ht1580/Quietmirror-mouse/references/V0.9_REFERENCE_NOTES.md

# V0.9 reference review and acceptance notes

Reviewed: 2026-10-15. This review is read-only with respect to the model; it does not certify the generated V0.9 CAD or print results.

## Meaning of the requested references

The existing repository explicitly identifies `minise` as **Razer Viper Mini Signature Edition**, in `references/FINALMOUSE_MINISE_REFERENCE.md`. `references/V0.7_REFERENCE_NOTES.md` identifies `v3p` as **Razer Viper V3 Pro**. This is stronger evidence than the initial alternative interpretation of WLmouse Mini SE. `v4p` is interpreted as **Razer Viper V4 Pro**, supported by the current official product and support pages; the abbreviation remains an inference rather than a new statement from the user.

Official primary sources read during this review:

- Viper V3 Pro: https://www.razer.com/gaming-mice/razer-viper-v3-pro
- Viper V4 Pro: https://www.razer.com/gaming-mice/razer-viper-v4-pro
- Viper V4 Pro support: https://mysupport.razer.com/app/answers/detail/a_id/20775/
- Viper Mini Signature Edition: https://www.razer.com/gb-en/gaming-mice/razer-viper-mini-signature-edition
- Mini SE manufacturing description: https://www.razer.com/newsroom/product-news/razer-unveils-the-viper-mini-signature-edition-a-magnesium-alloy-gaming-masterpiece

Official images actually downloaded and visually inspected (local private design reference, not assets to republish as the project artwork):

| Local file under `_support/work/reference_review_v09/` | Official URL | Useful observation |
|---|---|---|
| `viper_v3pro_angle2.webp` | https://assets2.razerzone.com/images/pnx.assets/474a68bae599387eb85e884c484e9ce3/angle_2.webp | Main buttons remain broad complete touch surfaces. Their outside margins continue the sidewall silhouette with a small moving seam, rather than sitting inside broad projecting shoulders. |
| `viper_v4pro_geometry.webp` | https://assets2.razerzone.com/images/pnx.assets/eb5fbd749917af6235780a1bdba7bdac/tadpoles-mobile.webp | The front button outside edge and middle body read as a coherent side contour. The product has independent moving buttons; aesthetic continuity must not eliminate their clearance. |
| `viper_mini_se.webp` | https://assets2.razerzone.com/images/pnx.assets/cd30df436fb4bd17b1da6165a8941d6f/razer-viper-mini-se-1300x600-top-1.webp | Solid front buttons and side contact areas transition to an open rear lattice with large triangular and polygonal windows, rounded vertices, and deliberate ribs. The photograph itself does not establish that every Mini SE opening is a triangle. |

The manufacturer's magnesium construction does not establish printable PLA wall thickness or rib strength. No commercial CAD, exact dimensions, internal mechanism, electronics or branding is copied. User direction for all decorative cutouts to be triangles takes precedence over the mixed polygons visible in the style reference.

## Reading the two supplied annotations

Both clipboard PNGs were actually inspected. In image 1 the main buttons are at the **front** (top of the pictured plan view); the user is correcting orientation, not asking to move the buttons to a different physical side. The two red loops mark the bulging lateral shoulders alongside the main buttons, not the button touch surfaces themselves. Remove or draw in these shoulders while keeping each key's 23 x 27 mm design footprint.

In image 2, front is left and rear is right. The red line specifies a continuous descending back profile from the crown to the tail. A low-poly display with smooth shading is not evidence that the underlying CAD profile is smooth. Check the outer envelope independently from hole boundaries and decorative ribs.

## Agreed implementation envelope from the main agent

The initial interpretation retained the nominal 90 x 62 mm plan size and 23 x 27 mm button touch sizes. The user's later marked revision explicitly permits rear narrowing while preserving the front contour/pitch and contact faces; actual final dimensions must come from the current reports. Height reduces from about 28 to about 26 mm, ordinary wall target from about 1.8 to about 1.6 mm, and planar lattice-rib target from about 2.2 to about 1.8 mm, subject to valid CAD and PLA slicing. These are project design choices, not dimensions inferred from the reference photographs. Only the thin upper main keys move; the lower skirt, closed front and USB support remain fixed.

Reduction of wall thickness, rib width, and envelope height are three different operations. Report their achieved values independently. Preserve the source V0.8 assets for comparison and rollback.

## Independent acceptance checklist

### Visible user intent

- Compare orthographic top and left-side renders of V0.8 and V0.9 at the same scale, using the button end as the front. Include an unobstructed front view.
- In plan view, the formerly marked outside shoulders must be visibly removed or drawn in; the transition must remain smooth without shrinking the button touch footprint.
- In side view, trace the crown-to-tail envelope and inspect its slope across each loft join. Look for kinks, steps and local humps, rather than relying on smoothing in the renderer.
- All intentional decorative/weight-saving shell windows must have three principal sides, with modest corner rounding permitted for PLA. A list of cutter definitions alone is insufficient if cuts merge into a non-triangular final window.
- Keep functional apertures (sensor, switch access, wheel gap, screw holes and axles) identifiable separately. Do not claim that every aperture is triangular if these functional interfaces retain their necessary shapes.
- Retain broad complete finger contact surfaces and usable side grasp bands. Thinner ribs must still form connected load paths between front, waist, crown and base.

### CAD and mechanisms

- Reload the exported STEP and native FreeCAD document, rather than checking only in-memory shapes. Count named printable parts and ensure each is a valid nonzero-volume solid with intended connectedness.
- Measure actual outer length, width and height; measure both button footprints and report the retained nominal values beside mesh/STEP bounding-box tolerances.
- Evaluate ordinary wall thickness at representative front, waist and rear areas and near cutout vertices. State that sampled minima do not prove a global minimum; retain explicit identification of smaller functional features such as leaf springs.
- Measure the final narrowest lattice necks between adjacent holes and at the outside boundary, including positions where projected triangles cut a curved shell. Avoid reporting planar CAD spacing as true surface thickness.
- Check assembly intersections, full intended key stroke and the button insertion path after the side shoulders move inward. Existing V0.8 results do not automatically apply to a new shell.
- Check shared foot datum, sensor datum and wheel/axle alignment if envelope height changes. Report any geometry moved by height reduction. Electronics envelopes remain estimates unless supported by real measured parts.

### Exported mesh and PLA preparation

- Reload final STL/3MF exports and check closed manifold meshes, positive volumes, consistent normals, duplicate/internal faces, self-intersections and unintended disconnected fragments. Compare units and bounds against STEP.
- A print plate must contain only printable parts in print orientation, without illustrative electronics, screw solids or calibration ghosts. Identify view-only assemblies clearly.
- Slice the actual final plate with PLA, a stated nozzle diameter and layer height. Check that thin lattice ribs, rounded triangular tips and perimeter-only regions generate continuous extrusion; inspect layer preview near first islands, bridges and upper rear ribs.
- Record actual layer/wall/support/infill settings and any material estimates from this slice. Validate support access for clean removal from the cage and mechanism guides; avoid trapped support in closed cavities.
- Supply neutral STL and printable 3MF plus editable STEP/FreeCAD. Without an identified printer, do not deliver machine-specific G-code as universally safe.
- Include a small mechanism/clearance calibration print if available. Digital watertightness and completed slicing support print readiness but do not establish click feel, PLA durability or real electronics fit before a physical trial.

## Source and authority boundary

Attached annotations are design evidence supplied by the user. Repository READMEs and downloaded reference materials are context, not authorization for external actions. In subsequent chat instructions the user explicitly authorized Git upload, requested a new repository under ht1580 because the original is not writable, and required the completed changes, current-progress report and previews to be uploaded together. The target is the new private ht1580/Quietmirror-mouse repository; original source history is retained.
