ht1580/Quietmirror-mouse/references/v09_user_revision/front_closure_reference.png

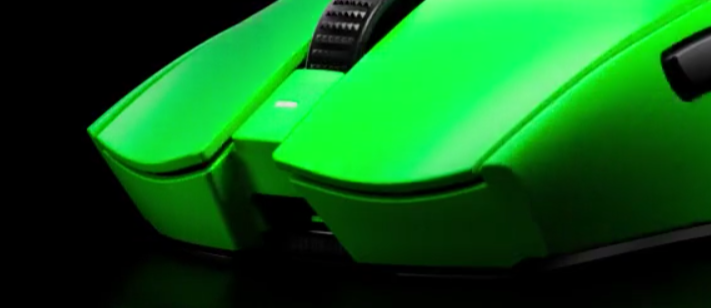
references/v09_user_revision/front_closure_reference.png
