ht1580/Quietmirror-mouse/references/v09_user_revision/marked_revision.png

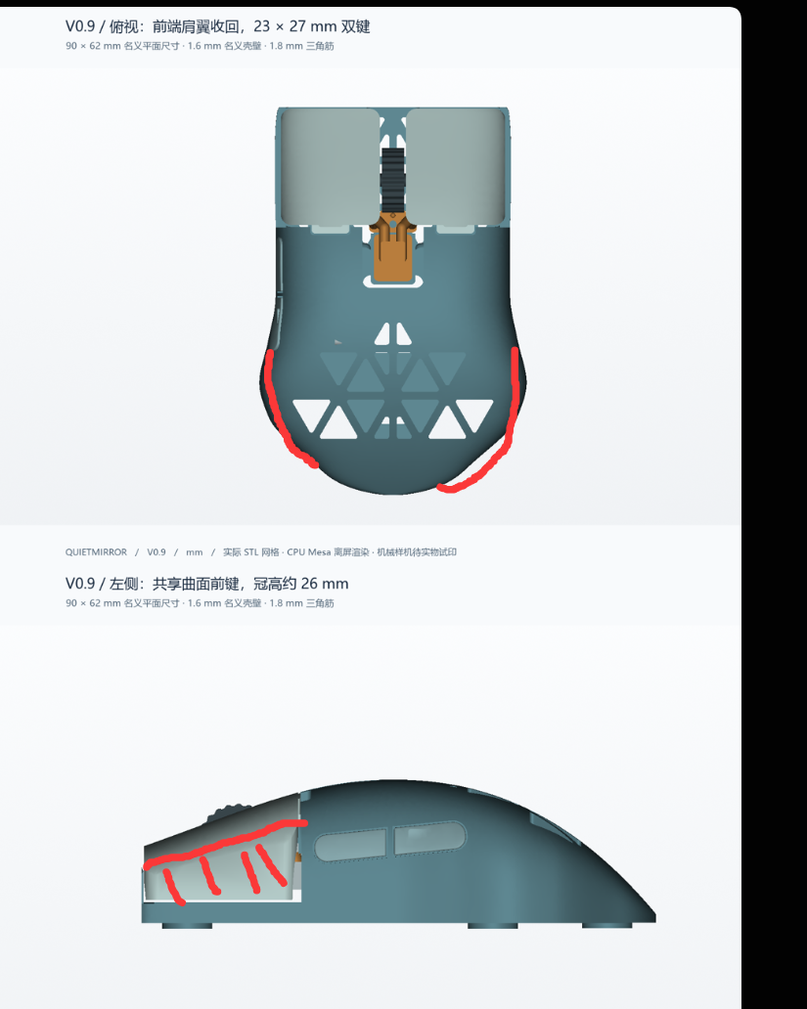
references/v09_user_revision/marked_revision.png
