ht1580/Quietmirror-mouse/views/v09/02_top.png

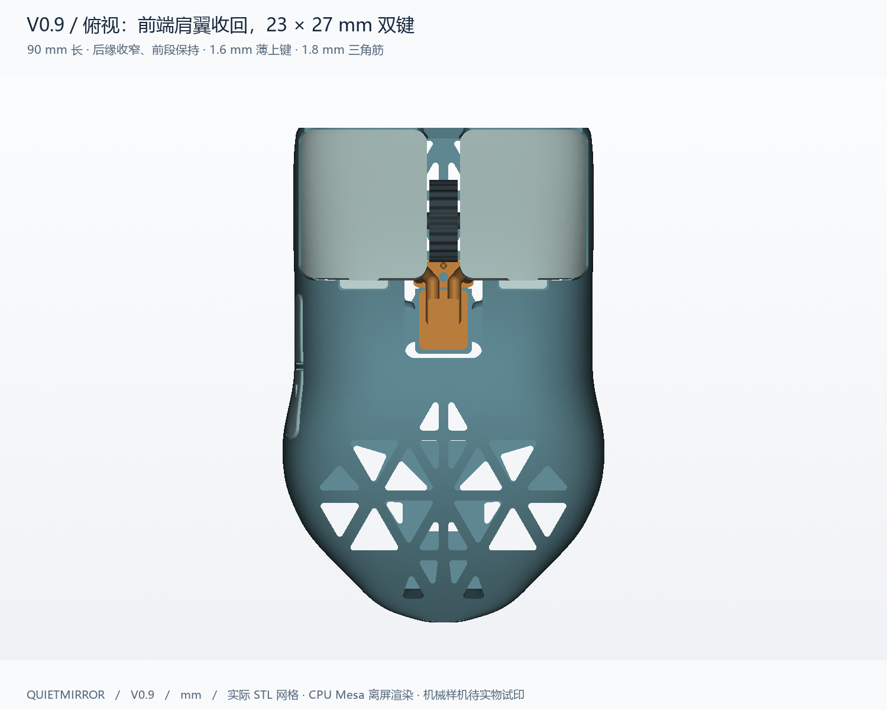
views/v09/02_top.png
