ht1580/Quietmirror-mouse/views/v09/05_right_side.png

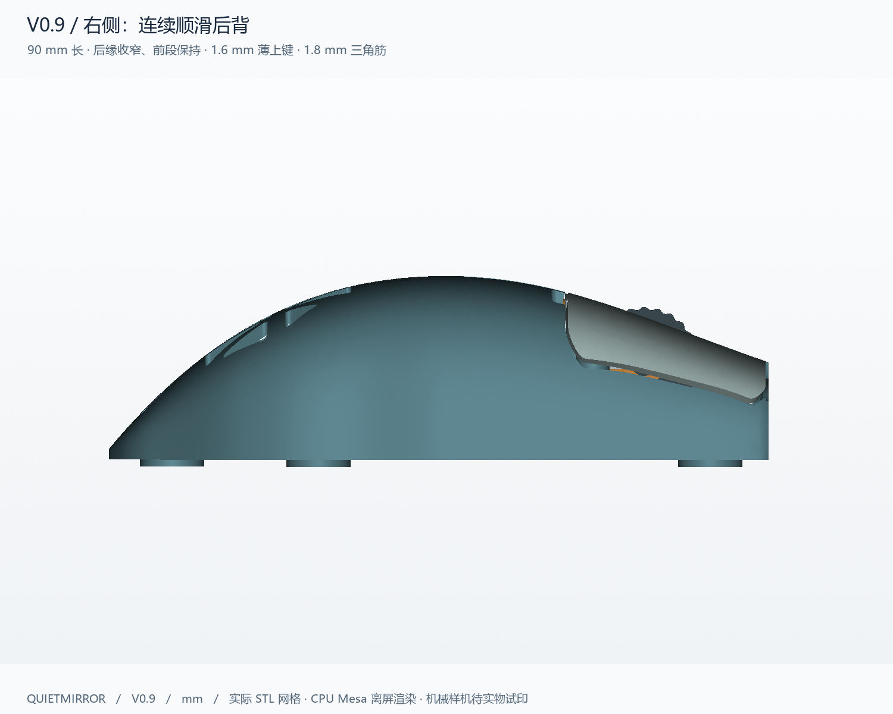
views/v09/05_right_side.png
