ht1580/Quietmirror-mouse/views/v09/06_front.png

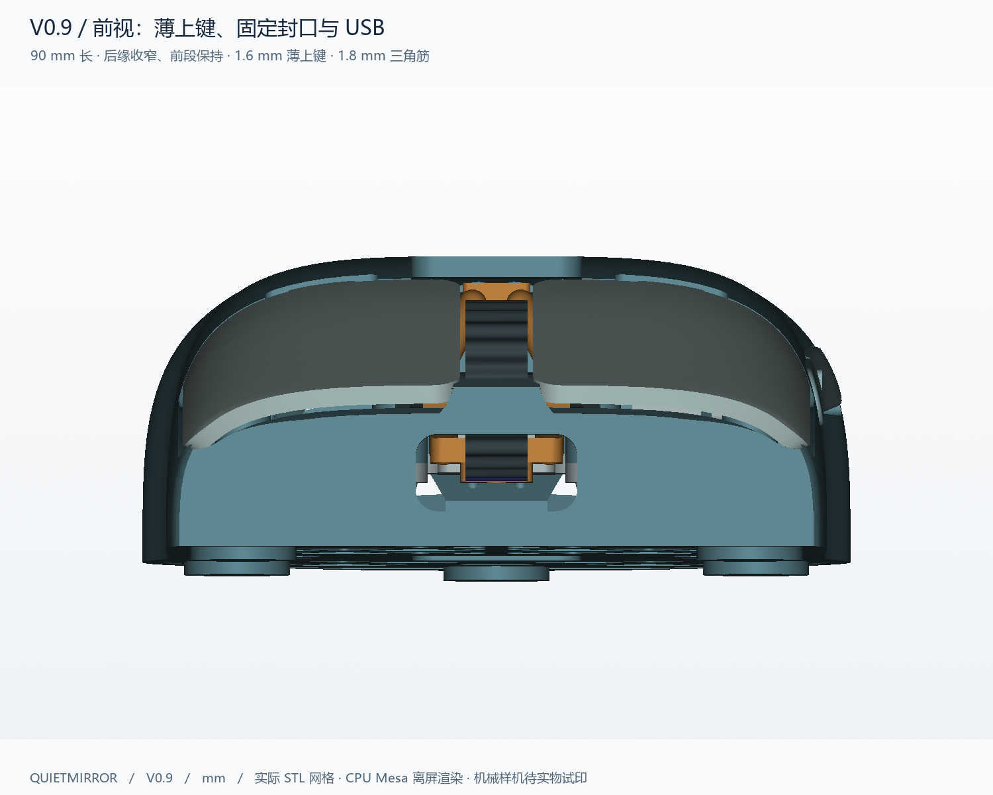
views/v09/06_front.png
