ht1580/Quietmirror-mouse/views/v09/before_side.png

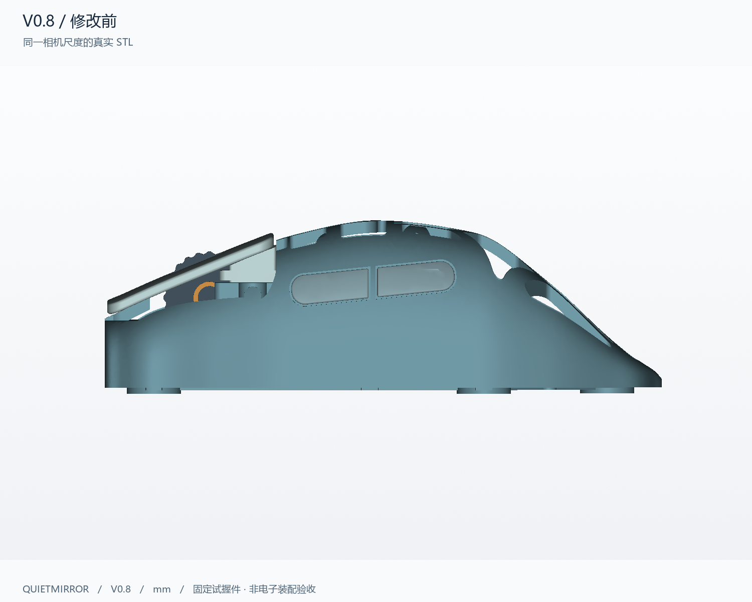
views/v09/before_side.png
