ht1580/Quietmirror-mouse/views/v09/before_top.png

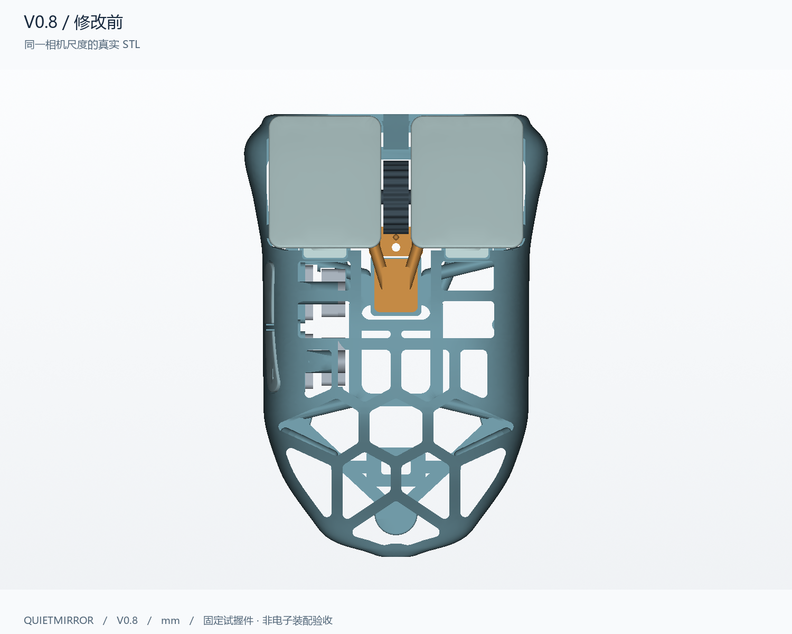
views/v09/before_top.png
