ht1580/Quietmirror-mouse/exports/v09/placed/AXLE.step

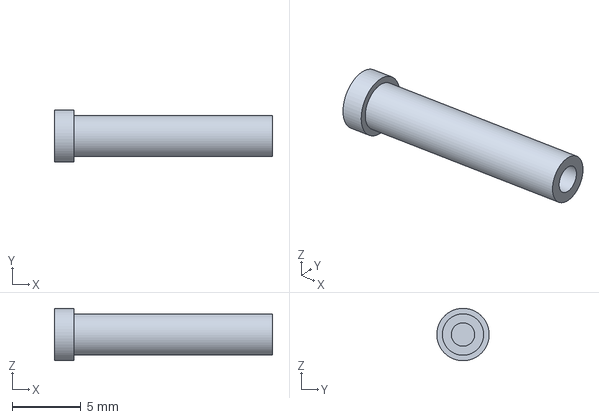
[picture p13: CAD file, 2026-10-15]
exports/v09/placed/AXLE.step
15.8 x 3.80 x 3.80 mm
