ht1580/Quietmirror-mouse/exports/v09/quietmirror_V0.9.FCStd

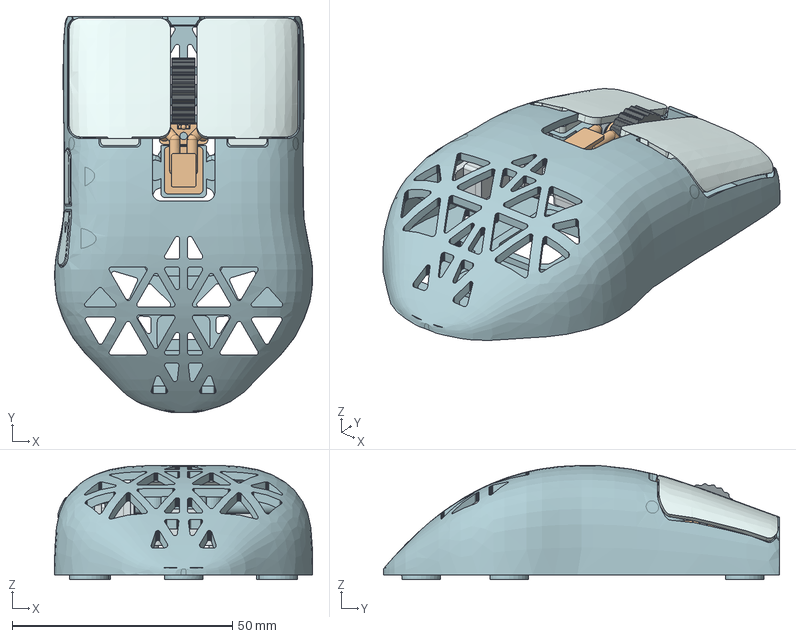
[picture p14: CAD file, 2026-10-15]
exports/v09/quietmirror_V0.9.FCStd
58.6 x 90.1 x 26.0 mm
left_KEY
right_KEY
thumb_front_KEY
thumb_rear_KEY
WHEEL
AXLE
AXLE_WASHER
WHEEL_CARRIER
DETENT_LEAF
left_RETAINER
left_TRAY
right_RETAINER
right_TRAY
middle_RETAINER
middle_TRAY
thumb_front_RETAINER
thumb_front_TRAY
thumb_rear_RETAINER
thumb_rear_TRAY
