ht1580/Quietmirror-mouse/exports/v09/calibration/AXLE_TEST.step

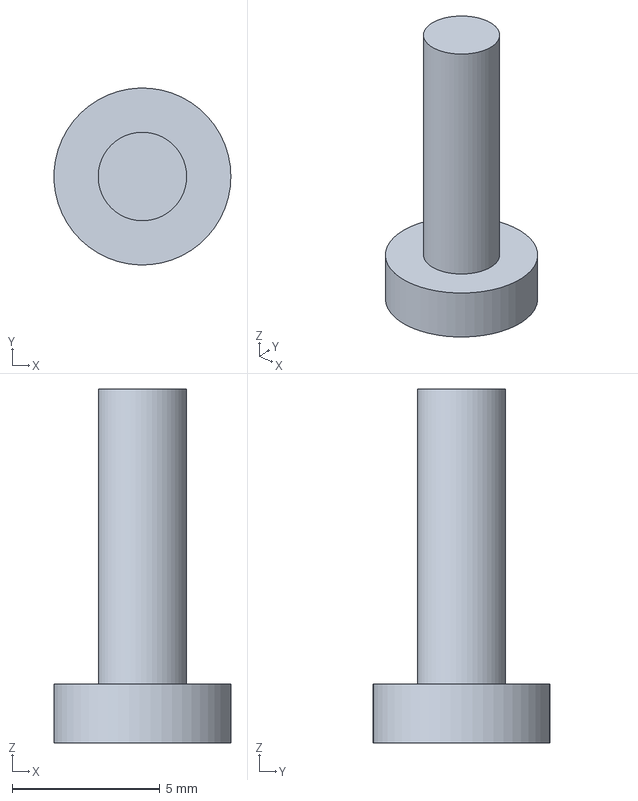
[picture p15: CAD file, 2026-10-15]
exports/v09/calibration/AXLE_TEST.step
5.99 x 6.00 x 12.0 mm
