ht1580/Quietmirror-mouse/exports/v09/placed/DETENT_LEAF.step

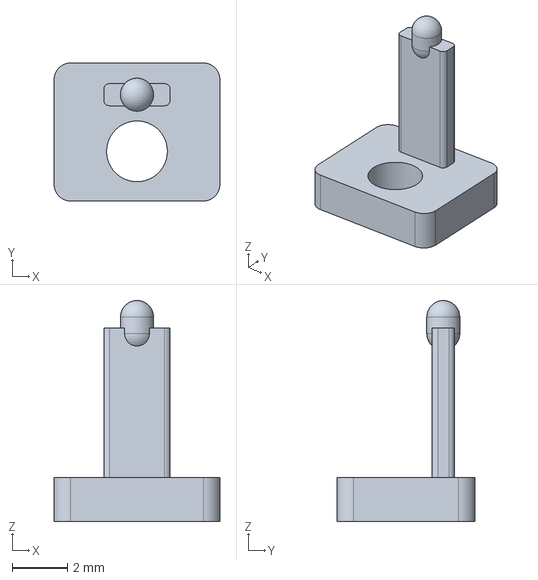
[picture p16: CAD file, 2026-10-15]
exports/v09/placed/DETENT_LEAF.step
6.00 x 5.00 x 8.00 mm
