ht1580/Quietmirror-mouse/exports/v09/print/thumb_front_KEY.step

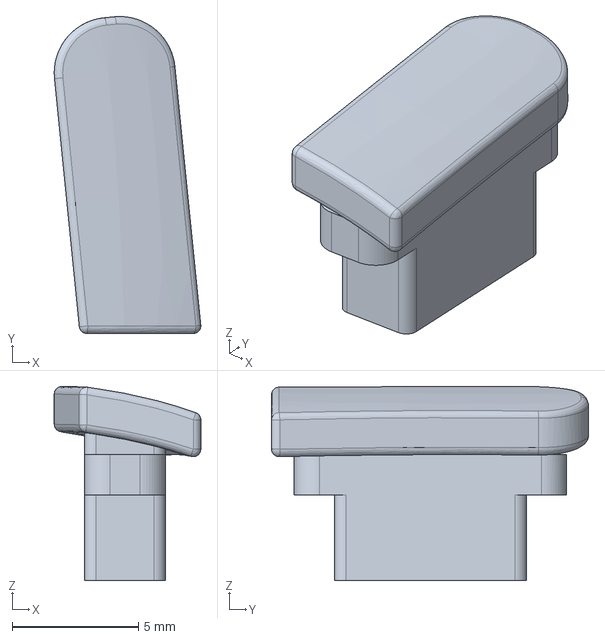
[picture p17: CAD file, 2026-10-15]
exports/v09/print/thumb_front_KEY.step
5.81 x 12.6 x 7.69 mm
