ht1580/Quietmirror-mouse/exports/v09/calibration/CLEARANCE_COUPON.step

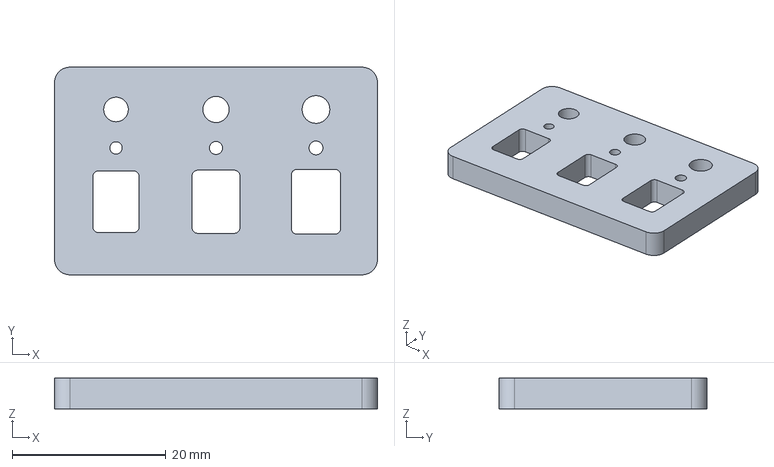
[picture p18: CAD file, 2026-10-15]
exports/v09/calibration/CLEARANCE_COUPON.step
42.0 x 27.0 x 4.00 mm
