ht1580/Quietmirror-mouse/exports/v09/placed/thumb_front_TRAY.step

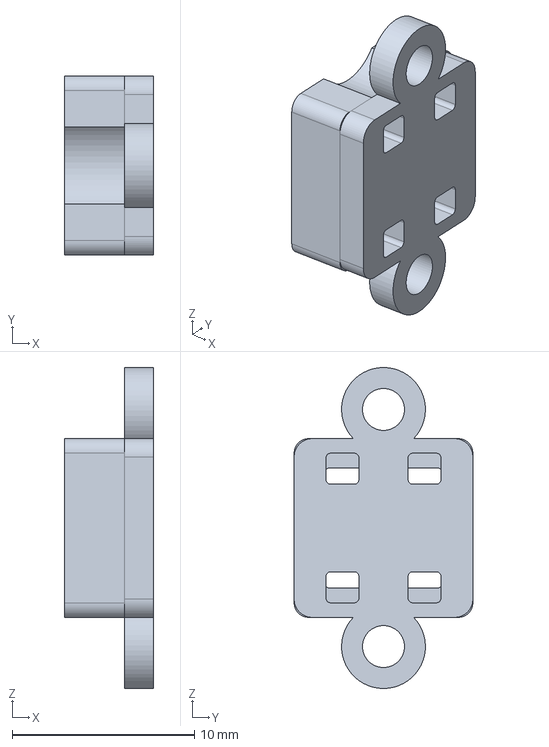
[picture p19: CAD file, 2026-10-15]
exports/v09/placed/thumb_front_TRAY.step
4.90 x 9.80 x 17.6 mm
