ht1580/Quietmirror-mouse/exports/v09/print/BODY.step

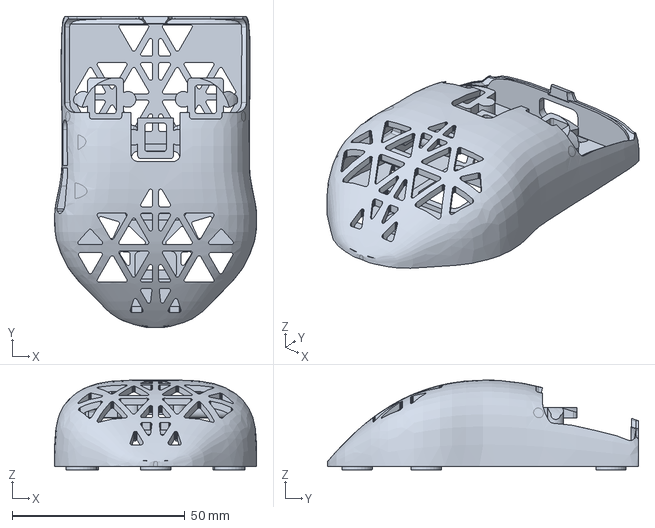
[picture p20: CAD file, 2026-10-15]
exports/v09/print/BODY.step
58.6 x 90.1 x 26.0 mm
