ht1580/Quietmirror-mouse/exports/v09/quietmirror_V0.9_PRINT_PLATE.3mf

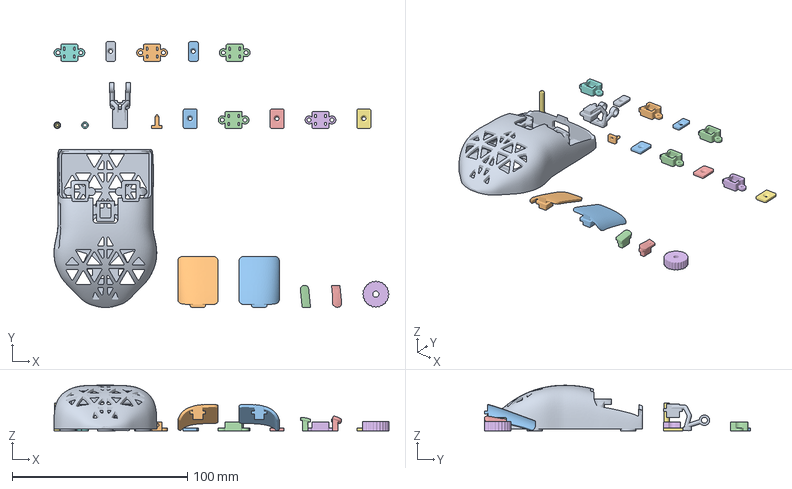
[picture p21: CAD file, 2026-10-15]
exports/v09/quietmirror_V0.9_PRINT_PLATE.3mf
191.3 x 151.7 x 26.0 mm
BODY.stl
left_KEY.stl
right_KEY.stl
thumb_front_KEY.stl
thumb_rear_KEY.stl
WHEEL.stl
AXLE.stl
AXLE_WASHER.stl
WHEEL_CARRIER.stl
DETENT_LEAF.stl
left_RETAINER.stl
left_TRAY.stl
right_RETAINER.stl
right_TRAY.stl
middle_RETAINER.stl
middle_TRAY.stl
thumb_front_RETAINER.stl
thumb_front_TRAY.stl
thumb_rear_RETAINER.stl
thumb_rear_TRAY.stl
