ht1580/Quietmirror-mouse/exports/v09/placed/left_KEY.step

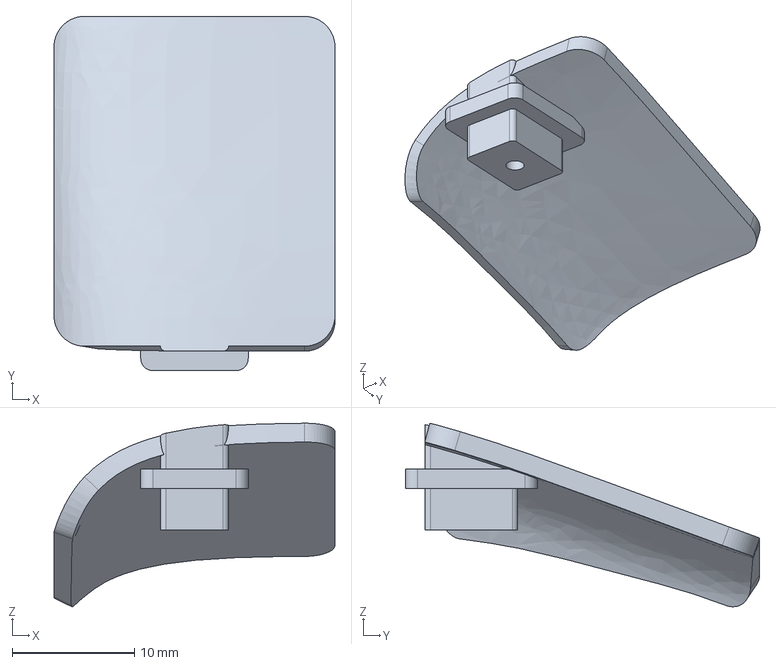
[picture p23: CAD file, 2026-10-15]
exports/v09/placed/left_KEY.step
23.0 x 29.0 x 15.0 mm
