ht1580/Quietmirror-mouse/exports/v09/print/WHEEL_CARRIER.step

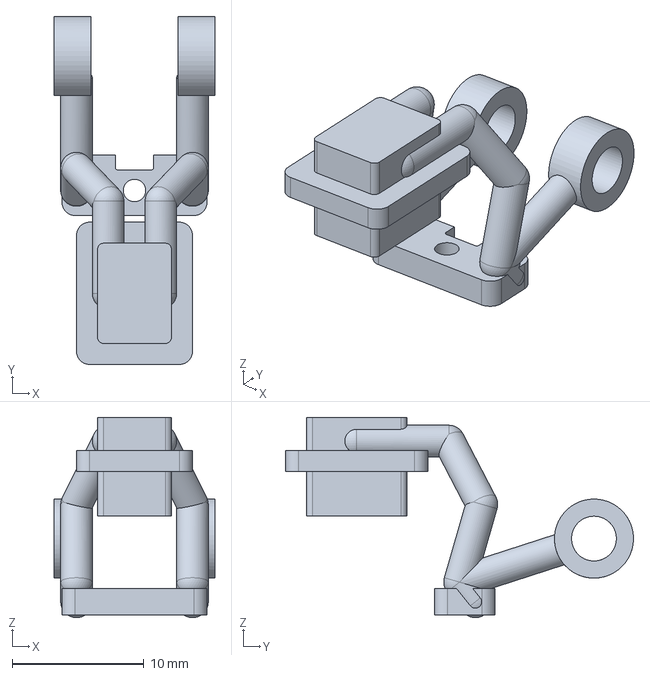
[picture p26: CAD file, 2026-10-15]
exports/v09/print/WHEEL_CARRIER.step
12.2 x 26.4 x 15.2 mm
