ht1580/Quietmirror-mouse/exports/v09/placed/thumb_rear_KEY.step

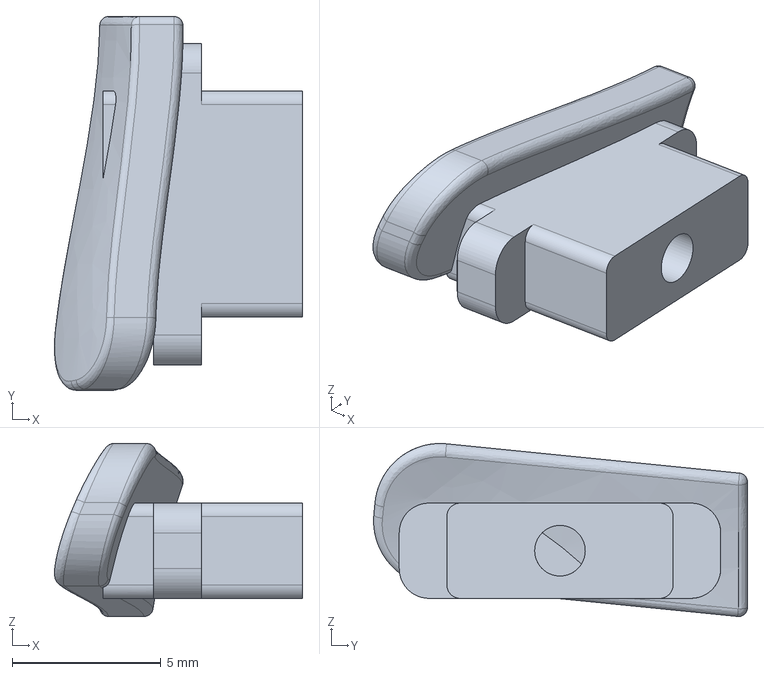
[picture p27: CAD file, 2026-10-15]
exports/v09/placed/thumb_rear_KEY.step
8.34 x 12.6 x 5.81 mm
