ht1580/Quietmirror-mouse/exports/v09/placed/WHEEL.step

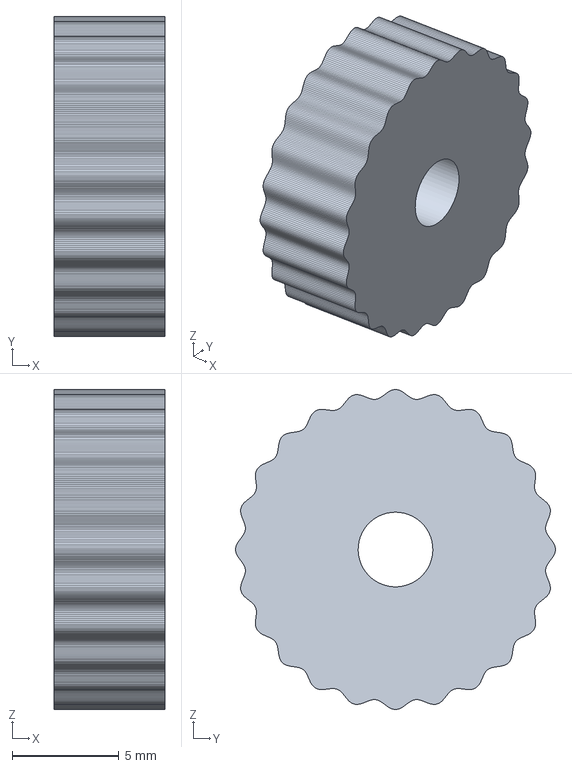
[picture p28: CAD file, 2026-10-15]
exports/v09/placed/WHEEL.step
5.20 x 15.0 x 15.0 mm
