ht1580/Quietmirror-mouse/(list of files, cad)

Other CAD files:
exports/v09/quietmirror_V0.9_VIEW_ONLY.3mf
exports/v09/placed/right_TRAY.step
exports/v09/print/middle_TRAY.step
exports/v09/print/thumb_front_TRAY.step
exports/v09/print/left_TRAY.step
exports/v09/placed/thumb_front_SWITCH_EXAMPLE.step
exports/v09/print/AXLE.step
exports/v09/placed/left_SWITCH_EXAMPLE.step
exports/v09/print/middle_RETAINER.step
exports/v09/placed/left_TRAY.step
exports/v09/print/left_KEY.step
exports/v09/placed/thumb_front_RETAINER.step
exports/v09/print/right_RETAINER.step
exports/v09/print/right_TRAY.step
exports/v09/placed/thumb_rear_RETAINER.step
exports/v09/print/left_RETAINER.step
exports/v09/placed/BODY.step
exports/v09/print/thumb_rear_KEY.step
exports/v09/placed/thumb_front_KEY.step
exports/v09/print/DETENT_LEAF.step
exports/v09/print/WHEEL.step
exports/v09/placed/thumb_rear_TRAY.step
exports/v09/print/thumb_front_RETAINER.step
exports/v09/placed/left_RETAINER.step
exports/v09/print/right_KEY.step
exports/v09/placed/right_RETAINER.step
exports/v09/print/thumb_rear_TRAY.step
exports/v09/placed/middle_TRAY.step
exports/v09/placed/right_KEY.step
exports/v09/placed/WHEEL_CARRIER.step
exports/v09/placed/middle_SWITCH_EXAMPLE.step
exports/v09/placed/right_SWITCH_EXAMPLE.step
exports/v09/calibration/AXLE_TEST.stl
exports/v09/calibration/CLEARANCE_COUPON.stl
exports/v09/calibration/STEM_TEST.stl
exports/v09/placed/AXLE.stl
exports/v09/placed/AXLE_WASHER.step
exports/v09/placed/AXLE_WASHER.stl
exports/v09/placed/BODY.stl
exports/v09/placed/DETENT_LEAF.stl
exports/v09/placed/WHEEL.stl
exports/v09/placed/WHEEL_CARRIER.stl
exports/v09/placed/left_KEY.stl
exports/v09/placed/left_RETAINER.stl
exports/v09/placed/left_SWITCH_EXAMPLE.stl
exports/v09/placed/left_TRAY.stl
exports/v09/placed/middle_RETAINER.stl
exports/v09/placed/middle_SWITCH_EXAMPLE.stl
exports/v09/placed/middle_TRAY.stl
exports/v09/placed/right_KEY.stl
exports/v09/placed/right_RETAINER.stl
exports/v09/placed/right_SWITCH_EXAMPLE.stl
exports/v09/placed/right_TRAY.stl
exports/v09/placed/thumb_front_KEY.stl
exports/v09/placed/thumb_front_RETAINER.stl
exports/v09/placed/thumb_front_SWITCH_EXAMPLE.stl
exports/v09/placed/thumb_front_TRAY.stl
exports/v09/placed/thumb_rear_KEY.stl
exports/v09/placed/thumb_rear_RETAINER.stl
exports/v09/placed/thumb_rear_SWITCH_EXAMPLE.stl
exports/v09/placed/thumb_rear_TRAY.stl
exports/v09/print/AXLE.stl
exports/v09/print/AXLE_WASHER.step
exports/v09/print/AXLE_WASHER.stl
exports/v09/print/BODY.stl
exports/v09/print/DETENT_LEAF.stl
exports/v09/print/WHEEL.stl
exports/v09/print/WHEEL_CARRIER.stl
exports/v09/print/left_KEY.stl
exports/v09/print/left_RETAINER.stl
exports/v09/print/left_TRAY.stl
exports/v09/print/middle_RETAINER.stl
exports/v09/print/middle_TRAY.stl
exports/v09/print/right_KEY.stl
exports/v09/print/right_RETAINER.stl
exports/v09/print/right_TRAY.stl
exports/v09/print/thumb_front_KEY.stl
exports/v09/print/thumb_front_RETAINER.stl
exports/v09/print/thumb_front_TRAY.stl
exports/v09/print/thumb_rear_KEY.stl
exports/v09/print/thumb_rear_RETAINER.stl
exports/v09/print/thumb_rear_TRAY.stl
