ht1580/Quietmirror-mouse/slicing/V0.9_PLA_0.4_0.20_ESTIMATE.ini

# Generic estimate profile, not a printer-specific production profile.
# Load the project into your actual printer profile before printing.
printer_technology = FFF
gcode_flavor = marlin2
bed_shape = 0x0,220x0,220x220,0x220
max_print_height = 220
nozzle_diameter = 0.4
filament_diameter = 1.75
filament_density = 1.24
filament_type = PLA
extrusion_multiplier = 1
layer_height = 0.2
first_layer_height = 0.2
perimeters = 4
top_solid_layers = 5
bottom_solid_layers = 5
fill_density = 20%
fill_pattern = gyroid
extrusion_width = 0.45
first_layer_extrusion_width = 0.45
external_perimeter_extrusion_width = 0.45
perimeter_extrusion_width = 0.45
infill_extrusion_width = 0.45
solid_infill_extrusion_width = 0.45
top_infill_extrusion_width = 0.42
support_material_extrusion_width = 0.4
perimeter_generator = arachne
perimeter_speed = 40
external_perimeter_speed = 25
small_perimeter_speed = 20
infill_speed = 50
solid_infill_speed = 35
top_solid_infill_speed = 25
bridge_speed = 25
gap_fill_speed = 20
first_layer_speed = 20
travel_speed = 150
temperature = 210
first_layer_temperature = 210
bed_temperature = 60
first_layer_bed_temperature = 60
cooling = 1
min_fan_speed = 80
max_fan_speed = 100
disable_fan_first_layers = 1
slowdown_below_layer_time = 10
min_print_speed = 10
brim_width = 4
brim_type = outer_only
skirts = 0
support_material = 1
support_material_auto = 1
support_material_style = snug
support_material_buildplate_only = 0
support_material_threshold = 45
support_material_contact_distance = 0.2
support_material_xy_spacing = 0.35
support_material_interface_layers = 3
support_material_interface_spacing = 0.2
support_material_spacing = 2.5
support_material_speed = 35
support_material_interface_speed = 25
support_tree_tip_diameter = 0.8
support_tree_branch_diameter = 2
support_tree_branch_distance = 1
support_tree_top_rate = 20%
raft_layers = 0
elefant_foot_compensation = 0.15
binary_gcode = 0
start_gcode = G28\nG90\nM83
layer_gcode = G92 E0
end_gcode = M104 S0\nM140 S0\nM107
use_relative_e_distances = 1
print_settings_id = V0.9 generic PLA estimate 0.20mm
filament_settings_id = PLA 1.24g-cm3 estimate
printer_settings_id = Generic 0.4mm 220mm ESTIMATE ONLY
